hpbock/esp12-environment-sensor/README.md

# esp12-environment-sensor
Environment sensor that is powered by a 18650 battery using a dht22 to sense temperature and humidity. Connectivity is provided wireless using an esp12 sleeping deeply most of the time.
