hpbock/esp12-environment-sensor/esp12-dht22.kicad_pcb

## KiCad design esp12-dht22.kicad_pcb (2020-04-02)

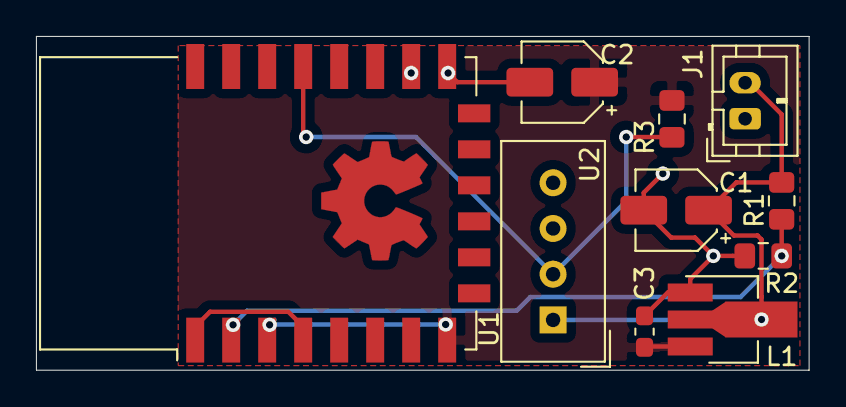
[picture p1: board esp12-dht22.kicad_pcb from above]

Board: 2 copper layers, 42.9 x 18.5 mm, 11 parts (1 on the bottom side), 7 nets.

Parts:
C1, C2: 10uF; CP_Elec_4x5.8
C3: 100nF; C_0603_1608Metric_Pad1.05x0.95mm_HandSolder
J1: Battery; JST_PH_B2B-PH-K_1x02_P2.00mm_Vertical
L1: HT7333-A; SOT-89-3_Handsoldering
R1: 330k; R_0805_2012Metric_Pad1.15x1.40mm_HandSolder
R2: 100k; R_0805_2012Metric_Pad1.15x1.40mm_HandSolder
R3: 4k7; R_0805_2012Metric_Pad1.15x1.40mm_HandSolder
R4: 2k2; R_0805_2012Metric_Pad1.15x1.40mm_HandSolder
U1: ESP-12E
U2: DHT22; Aosong_DHT11_5.5x12.0_P2.54mm

Connections:
+BATT: C1.1, J1.2, L1.2, R1.1, U2.1
ADC: R1.2, R2.1, U1.2
DHT_Data: R3.2, U1.19, U2.2
DeepSleep: U1.1, U1.4
GND: C1.2, C2.2, C3.2, J1.1, L1.1, R2.2, R4.2, U1.15, U2.4
unnamed: R4.1, U1.16
VCC: C2.1, C3.1, L1.3, R3.1, U1.3, U1.8
