hpbock/esp12-environment-sensor/(threads)

Thread 1 (2019-07-23):

connection for wakeup from deep sleep is missing

hpbock, 2019-07-23:
The connection between `GPIO16` and `RST` to wake up the ESP8266 from deep sleep is missing. See this [tutorial](https://randomnerdtutorials.com/esp8266-deep-sleep-with-arduino-ide/) or the [arduino core reference](https://arduino-esp8266.readthedocs.io/en/latest/libraries.html#esp-specific-apis) for details.

Closed 2019-07-23.

Thread 2 (2019-07-31):

esp12e does not boot

hpbock, 2019-07-31:
* [x] the enable pin must be pulled to VCC in order for the esp12e to start
* [x] GPIO15 must be pulled low for start
[reference](http://stefanfrings.de/esp8266/)

Closed 2019-08-19.

Thread 3 (2019-08-10):

DHT22 voltage

hpbock, 2019-08-10:
The DHT22 needs at least 3.3V to work properly. Maybe it should be connected directly to the battery. Data pin might need to be level shifted then.

Closed 2020-06-22.
