hpbock/esp12-environment-sensor/(commit log)

2019-07-05 added initial kicad project
    [esp12-dht22.kicad_pcb, esp12-dht22.sch]
2019-07-05 added power supply
    [esp12-dht22.kicad_pcb, esp12-dht22.sch]
2019-07-06 added esp, dht22 and battery voltage divider for adc
    [esp12-dht22.kicad_pcb, esp12-dht22.sch]
2019-07-09 changed data pin from gpio5 to gpio4
    [esp12-dht22.kicad_pcb, esp12-dht22.sch]
2019-07-14 added 100nF caps
    [esp12-dht22.kicad_pcb, esp12-dht22.sch]
2019-07-15 added JST PH connector for battery
    [esp12-dht22.kicad_pcb, esp12-dht22.sch]
2019-07-17 moved via and added date to bottom silkscreen
    [esp12-dht22.kicad_pcb]
2019-07-18 removed layer alignment target
    [esp12-dht22-B_Cu.gbl, esp12-dht22-B_Mask.gbs, esp12-dht22-B_Paste.gbp, esp12-dht22-B_SilkS.gbo, esp12-dht22-Edge_Cuts.gm1, esp12-dht22-F_Cu.gtl, esp12-dht22-F_Mask.gts, esp12-dht22-F_Paste.gtp]
2019-07-23 added connection between RST and GPIO16 for wakeup from deep sleep fixes #1
    [esp12-dht22.kicad_pcb, esp12-dht22.sch]
2019-08-19 swapped pins of J1 fixes #4
    [esp12-dht22.kicad_pcb, esp12-dht22.sch]
2019-08-19 connected ENABLE and GPIO15 to boot properly fixes #2
    [esp12-dht22.kicad_pcb, esp12-dht22.sch]
2020-04-02 connected DHT22 to Vbatt fixes #3
    [esp12-dht22.kicad_pcb, esp12-dht22.sch]
2020-06-22 added soldered 18650 battery holder closes #6
    [esp12-dht22.sch]
2020-06-22 DHT22 is now supplied with Vbat closes #3
    [esp12-dht22.sch]
